relax81/Chorus32-ESP32LapTimer/pcb/letstinker/v02/BOM_Board1_Schematic1_2023-08-08.xlsx

No. | Quantity | Designator | Footprint | Value | Manufacturer Part | Manufacturer | Supplier Part | Comment
1 | 1 | BAT1 | BH-18650-A |  | BH-18650-A | null |  | BH-18650
2 | 1 | BUZ1 | BUZ-TH_BD12.0-P7.60-D0.6-FD |  | YS-MBZ12095DYB05 | Fengming(锋鸣电子) | C409831 | {ManufacturerPart!}
3 | 4 | C1,C4,C6,C7 | C0603 | 10uF |  |  |  | 10uF
4 | 3 | C2,C3,C9 | C0603 | 100nF |  |  |  | 100nF
5 | 2 | C5,C8 | C0805 | 10uF |  |  |  | 10uF
6 | 1 | C10 | C0603 | 1uF |  |  |  | 1uF
7 | 1 | CM1 | COMM-SMD_12P_RX5808 |  | RX5808 |  | C2908157 | {ManufacturerPart!}
8 | 1 | CN1 | CONN-TH_B2B-XH-A-LF-SN |  | B2B-XH-A(LF)(SN) | JST | C158012 | B2B-XH-A(LF)(SN)
9 | 4 | H1,H2,H4,H12 | HDR-TH_4P-P2.54-V-M
10 | 3 | H3,H5,H6 | HDR-TH_3P-P2.54-V-M
11 | 4 | H8,H9,H10,H11 | M3_HOLE |  |  |  |  | M3_HOLE
12 | 1 | JP1 | RF-SMD_FRF05002-JSS103M |  | U.FL-R-SMT-1(80) | HRS(广濑) | C88374 | U.FL-R-SMT-1(80)
13 | 1 | LED1 | LED0603-R-RD
14 | 2 | Q1,Q2 | SOT-23_L2.9-W1.3-P1.90-LS2.4-BR |  | Si2302CDS-T1-GE3 | VISHAY(威世) | C10488 | Si2302CDS-T1-GE3,{ManufacturerPart!}
15 | 1 | Q3 | SC-70-6_L2.2-W1.3-P0.65-LS2.1-BR |  | UMH3N | CJ(江苏长电/长晶) | C62892 | {ManufacturerPart!}
16 | 1 | R1 | R0805 | 100k |  |  |  | 100k
17 | 4 | R2,R3,R4,R14 | R0805 | 1K |  |  |  | 1K
18 | 2 | R5,R6 | R0603 | 5k1 |  |  |  | 5k1
19 | 1 | R7 | R0603 | 100K |  |  |  | 100K
20 | 3 | R8,R13,R15 | R0603 | 10K |  |  |  | 10K
21 | 1 | R9 | R0603 | 330K |  |  |  | 330K
22 | 2 | R10,R11 | R0402 | 4k7 |  |  |  | 4k7
23 | 1 | R12 | R0603 | 360R |  |  |  | 360R
24 | 1 | SW1 | SW-SMD_4P-L5.2-W5.2-P3.70-LS6.4 |  | TS5215A250gf | SHOUHAN(首韩) | C388295 | {ManufacturerPart!}
25 | 1 | U1 | USB-C-SMD_G-SWITCH_GT-USB-7010ASV |  | GT-USB-7010ASV | G-Switch(品赞) | C2988369 | {ManufacturerPart!}
26 | 1 | U2 | WIFI-SMD_ESP32-WROOM-32E |  | ESP32-WROOM-32E-N8 | ESPRESSIF(乐鑫) | C701342 | {ManufacturerPart!}
27 | 1 | U3 | MH-CD42
28 | 1 | U4 | SOT-223-4_L6.5-W3.5-P2.30-LS7.0-BR |  | SPX1117M3-L-3-3/TR | MaxLinear | C6862 | {ManufacturerPart!}
29 | 1 | U5 | SOP-16_L10.0-W3.9-P1.27-LS6.0-BL |  | CH340C | WCH(南京沁恒) | C84681 | {ManufacturerPart!}
30 | 2 | U6,U7 | SOLDERJUMPER3 |  |  |  |  | SOLDERJUMPER3
31 | 1 | U8 | switch_rightangle-b9-11 |  |  |  |  | {ManufacturerPart!}
