relax81/Chorus32-ESP32LapTimer/3dprint/letstinker_v02/led_foil_cover_v02.stl

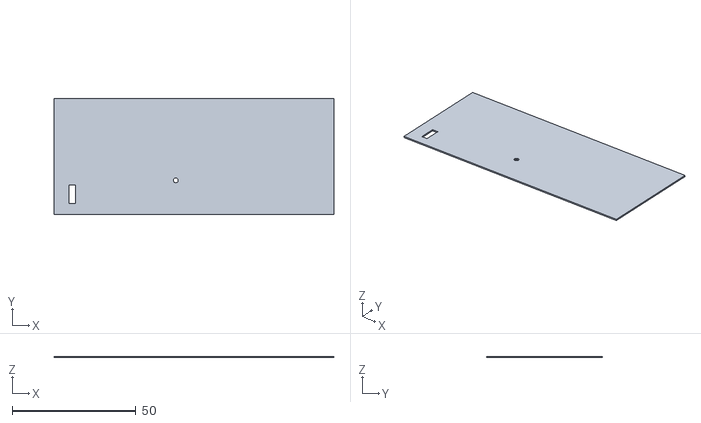
[picture p1: CAD file, 2023-08-08]
3dprint/letstinker_v02/led_foil_cover_v02.stl
113.4 x 46.9 x 0.6
