relax81/Chorus32-ESP32LapTimer/3dprint/letstinker_v02/button_cover_v02.stl

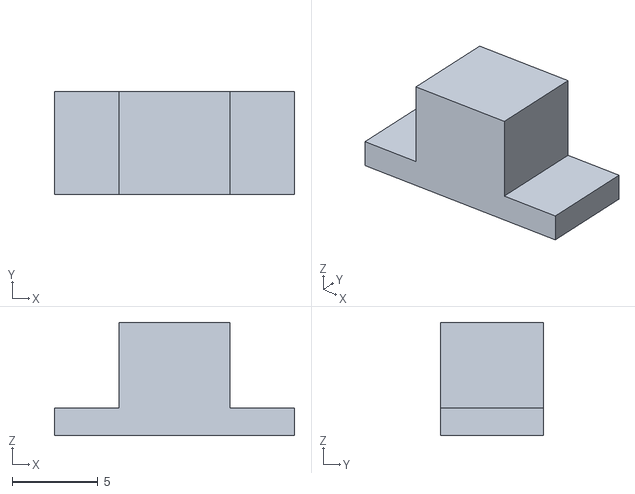
[picture p2: CAD file, 2023-08-08]
3dprint/letstinker_v02/button_cover_v02.stl
14.0 x 6.00 x 6.60
