relax81/Chorus32-ESP32LapTimer/3dprint/letstinker_v02/lid_v02.stl

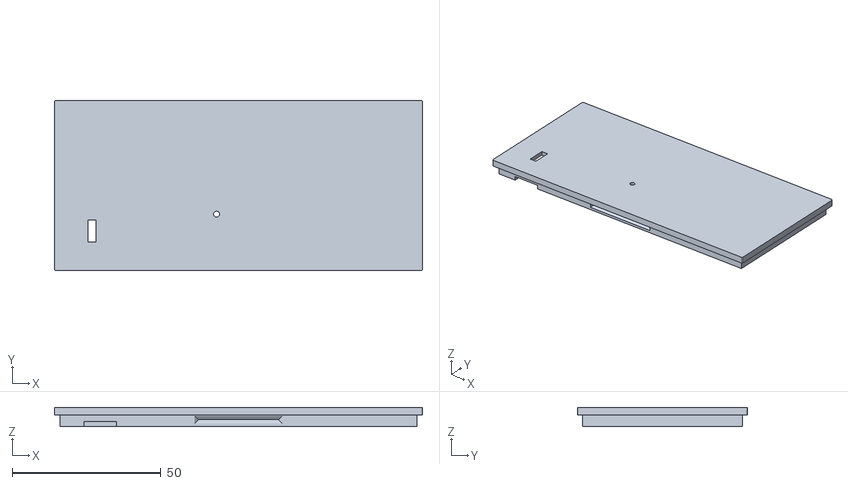
[picture p4: CAD file, 2023-08-08]
3dprint/letstinker_v02/lid_v02.stl
123.8 x 57.3 x 6.40
