relax81/Chorus32-ESP32LapTimer/3dprint/letstinker_v02/button_slider_v02.stl

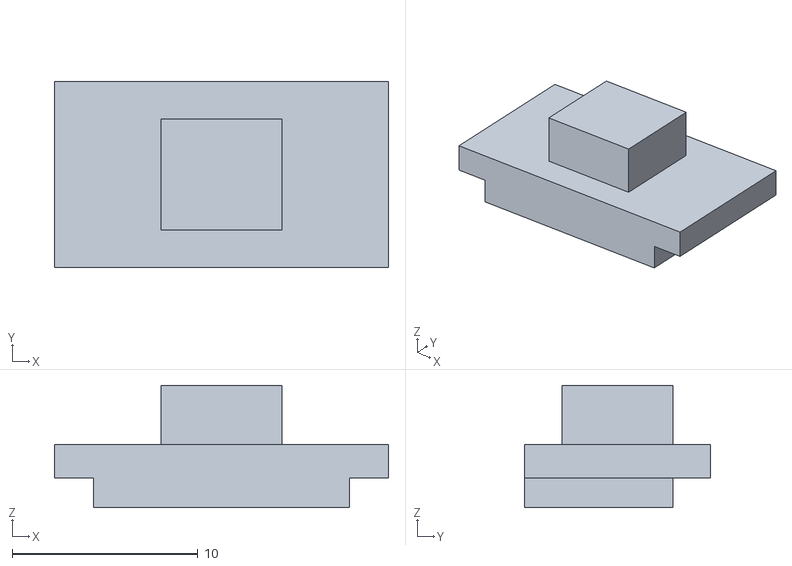
[picture p5: CAD file, 2023-08-08]
3dprint/letstinker_v02/button_slider_v02.stl
18.0 x 10.0 x 6.60
