relax81/Chorus32-ESP32LapTimer/pcb/letstinker/v02/LapTimer_v02_Schematic1_2023-07-12.pdf

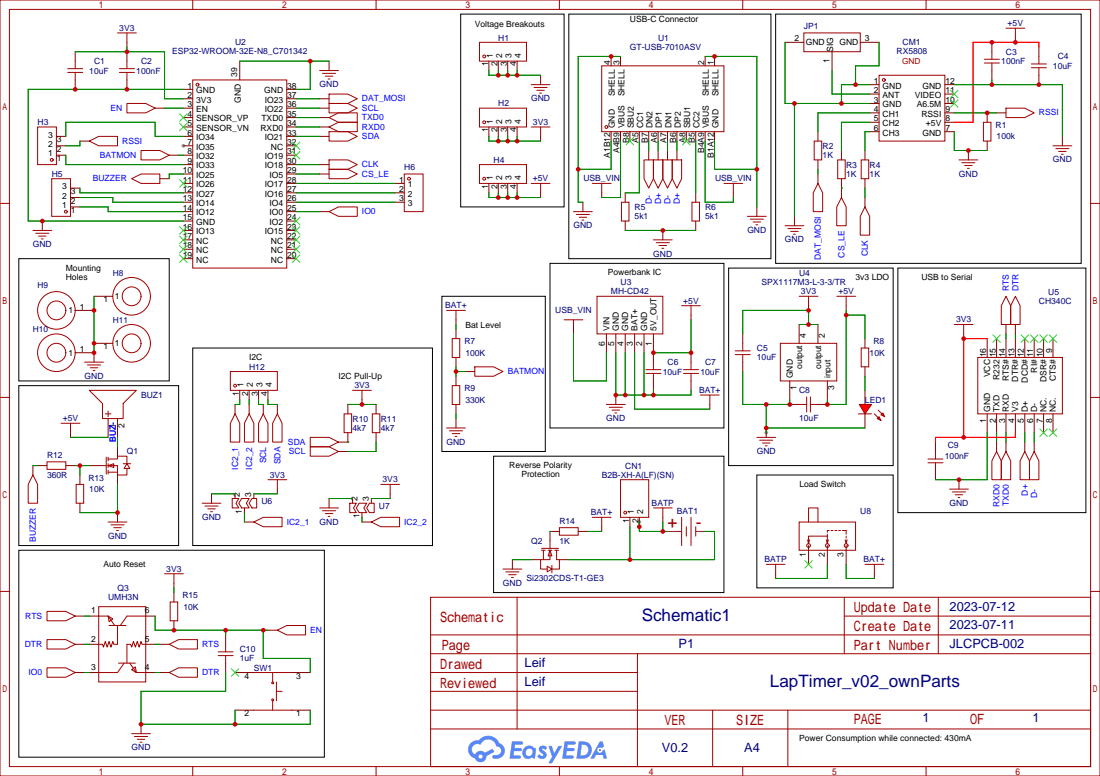
[picture p6: page 1]

1 GND B1A12 VBUS B4A9 CC2 B5 SBU1 A8 DP2 B6 DN1 A7 DP1 A6 DN2 B7 CC1 A5 SBU2 B8 VBUS A4B9 GND A1B12

Power Consumption while connected: 430mA
