relax81/Chorus32-ESP32LapTimer/(commit log)

2023-05-10 added custom pcb and vbat working
2023-08-05 fixed bat reading by increasing to 11db on ADC CH
    [ADC.cpp, config_letstinker_pcb.h, settings_eeprom.h]
2023-08-08 added 3d print case and pcb files
    [BOM_Board1_Schematic1_2023-08-08.xlsx, box_v02.stl, button_cover_v02.stl, button_slider_v02.stl, led_foil_cover_v02.stl, lid_v02.stl]
